ImZadeQasemzade/QDD5010-Actuator/CAD/V2/V2 arm.png

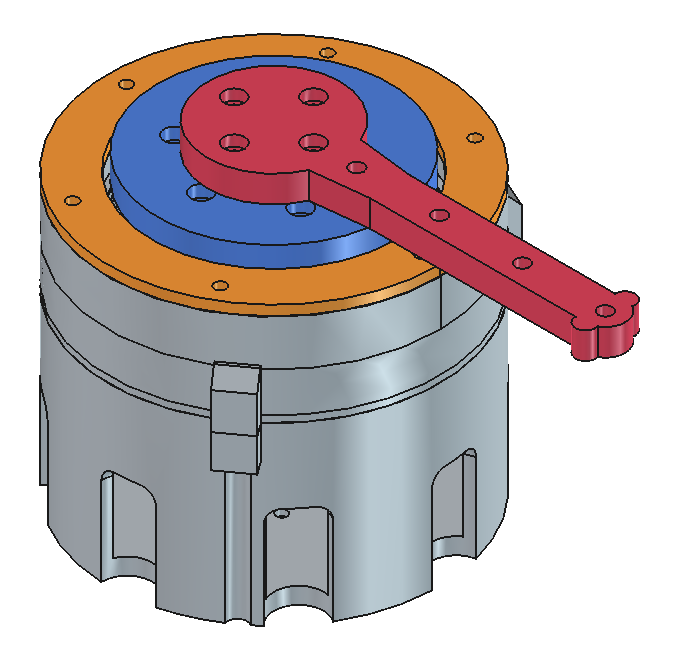
CAD/V2/V2 arm.png
