ImZadeQasemzade/QDD5010-Actuator/CAD/V2/PlanetaryGearBox 5010.FCStd

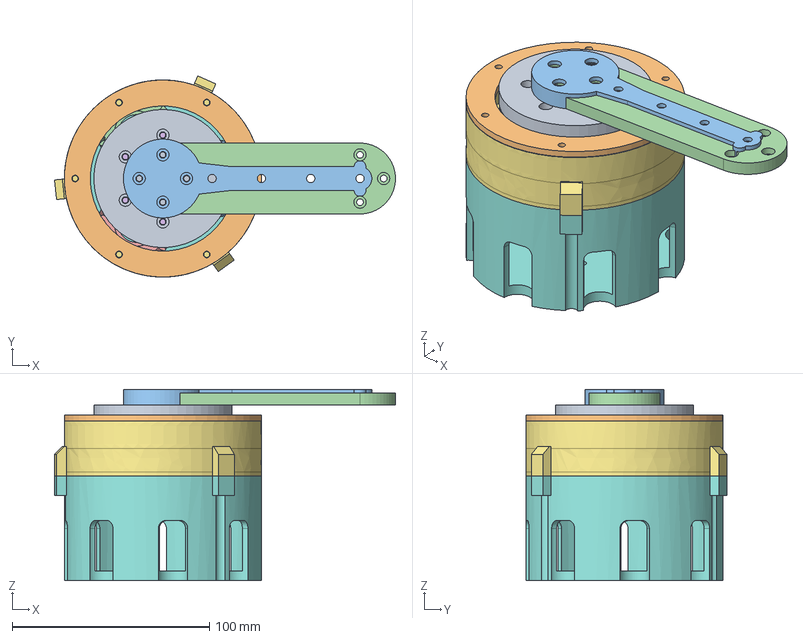
[picture p7: CAD file, 2026-11-08]
CAD/V2/PlanetaryGearBox 5010.FCStd
173.0 x 102.0 x 97.1 mm
Rotor Adapter
Sun
Planet 1
Planet 2
Planet 3
Carrier
Ring
Base
Output Flange
Bearing Retainer
Arm
Arm A1
