ImZadeQasemzade/QDD5010-Actuator/CAD/V2/PlanetaryGearBox 5010-Arm A1 Pusher.stl

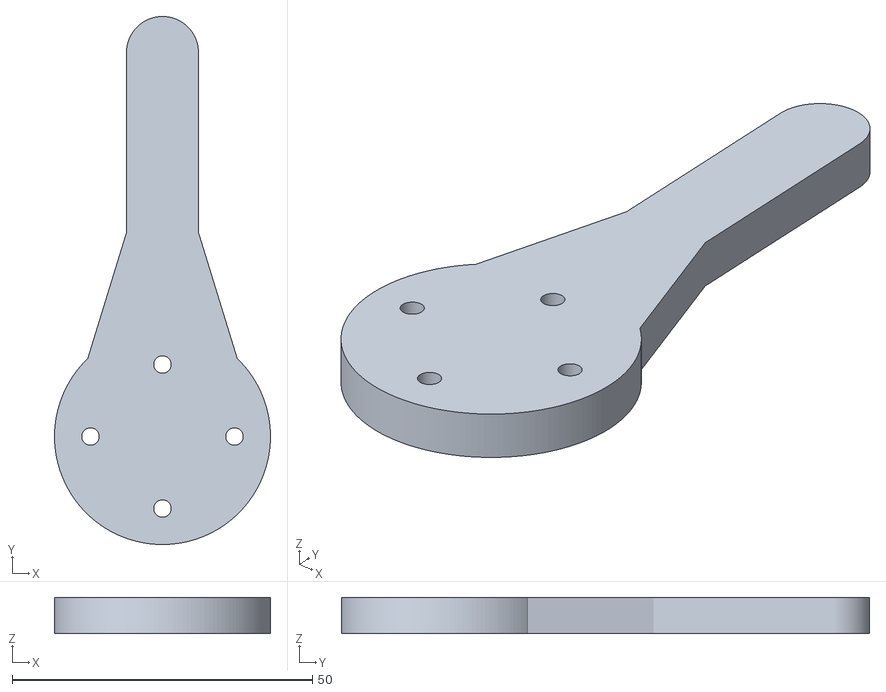
[picture p8: CAD file, 2026-11-08]
CAD/V2/PlanetaryGearBox 5010-Arm A1 Pusher.stl
36.0 x 88.0 x 6.00
