ImZadeQasemzade/QDD5010-Actuator/CAD/V2/PlanetaryGearBox 5010-Arm A1.3mf

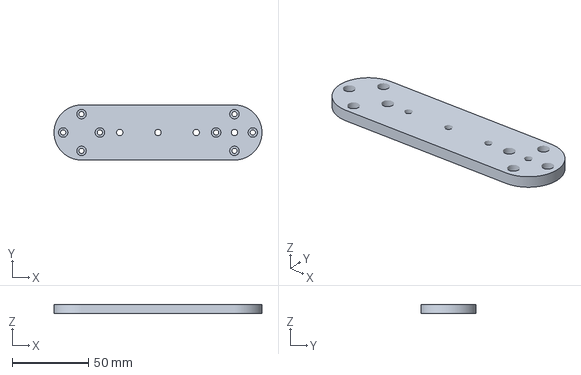
[picture p9: CAD file, 2026-11-08]
CAD/V2/PlanetaryGearBox 5010-Arm A1.3mf
136.0 x 36.0 x 6.00 mm
