ImZadeQasemzade/QDD5010-Actuator/CAD/V2/PlanetaryGearBox 5010-Sun.3mf

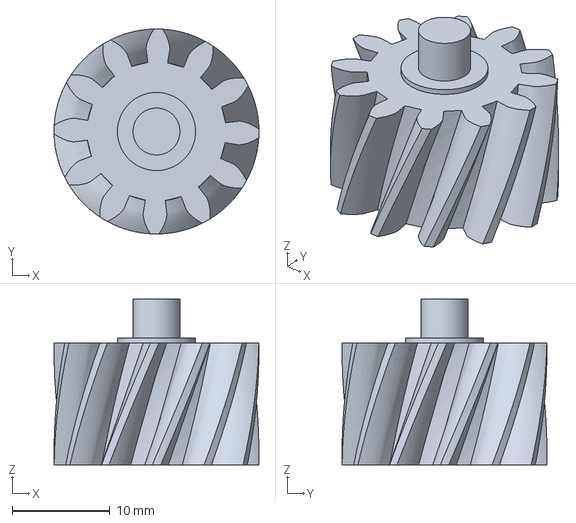
[picture p10: CAD file, 2026-11-03]
CAD/V2/PlanetaryGearBox 5010-Sun.3mf
21.0 x 21.0 x 17.0 mm
