ImZadeQasemzade/QDD5010-Actuator/CAD/V2/PlanetaryGearBox 5010-Rotor Adapter.3mf

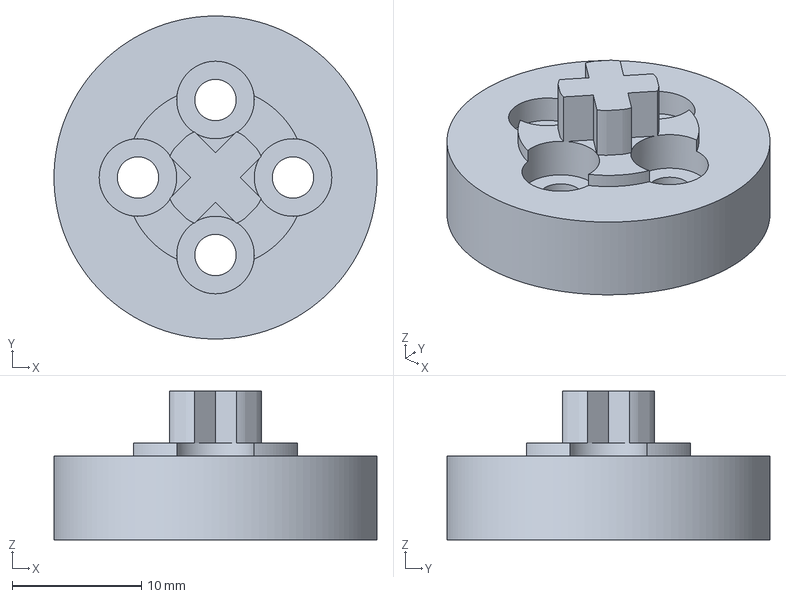
[picture p11: CAD file, 2026-11-03]
CAD/V2/PlanetaryGearBox 5010-Rotor Adapter.3mf
25.0 x 25.0 x 11.5 mm
