ImZadeQasemzade/QDD5010-Actuator/CAD/V2/PlanetaryGearBox 5010-Planet 2.3mf

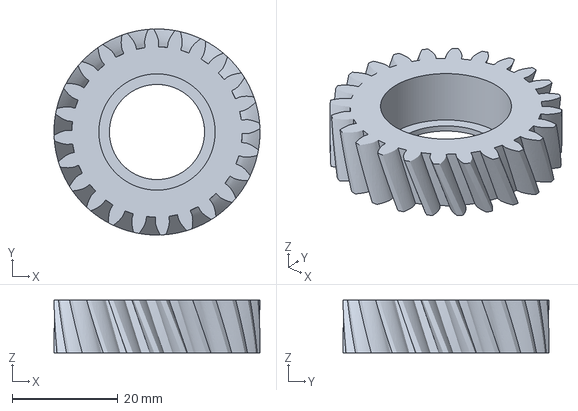
[picture p12: CAD file, 2026-11-03]
CAD/V2/PlanetaryGearBox 5010-Planet 2.3mf
39.0 x 39.0 x 10.0 mm
