ImZadeQasemzade/QDD5010-Actuator/CAD/V2/PlanetaryGearBox 5010-Carrier.3mf

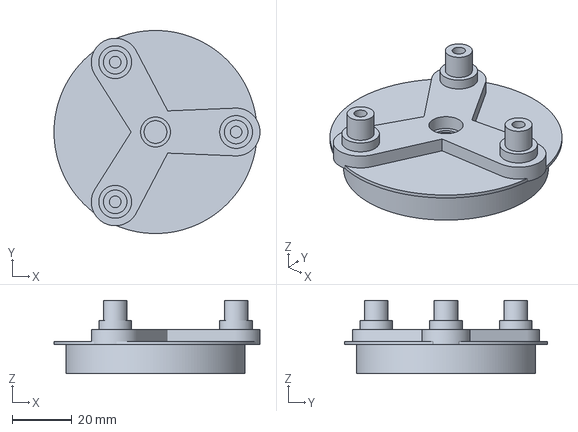
[picture p13: CAD file, 2026-11-03]
CAD/V2/PlanetaryGearBox 5010-Carrier.3mf
69.0 x 68.0 x 24.6 mm
