ImZadeQasemzade/QDD5010-Actuator/CAD/V2/PlanetaryGearBox 5010-Output Flange.3mf

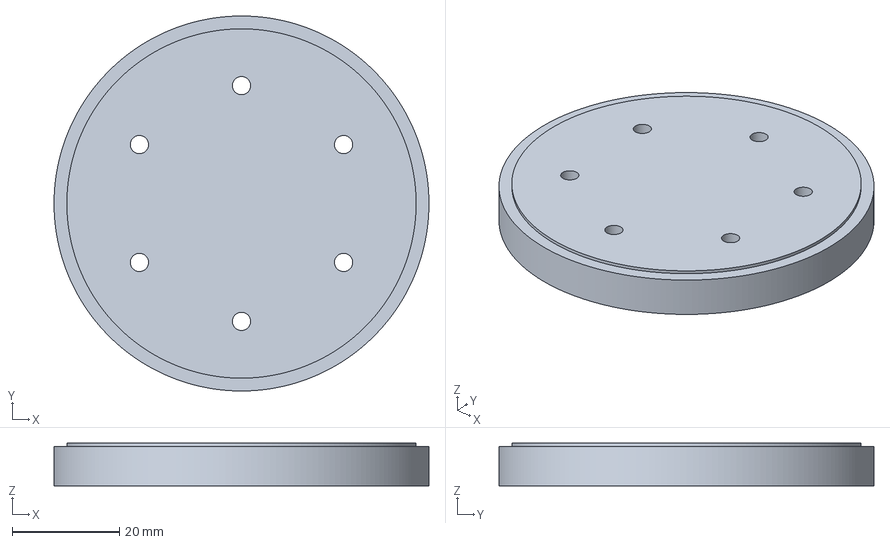
[picture p14: CAD file, 2026-11-03]
CAD/V2/PlanetaryGearBox 5010-Output Flange.3mf
70.0 x 70.0 x 8.00 mm
