ImZadeQasemzade/QDD5010-Actuator/CAD/V2/PlanetaryGearBox 5010-Base.3mf

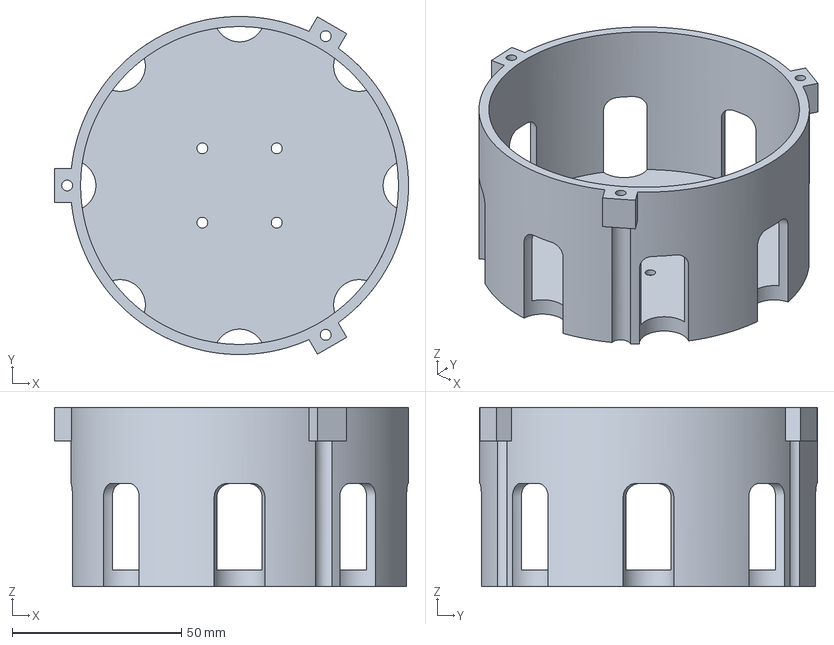
[picture p15: CAD file, 2026-11-03]
CAD/V2/PlanetaryGearBox 5010-Base.3mf
104.7 x 100.0 x 53.1 mm
