ImZadeQasemzade/QDD5010-Actuator/CAD/V2/PlanetaryGearBox 5010-Ring.3mf

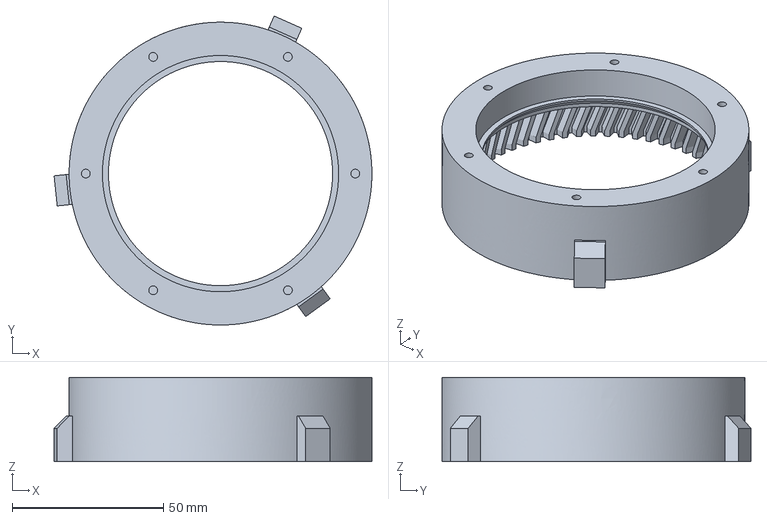
[picture p16: CAD file, 2026-11-03]
CAD/V2/PlanetaryGearBox 5010-Ring.3mf
105.0 x 102.0 x 27.8 mm
