ImZadeQasemzade/QDD5010-Actuator/CAD/V2/PlanetaryGearBox 5010-Arm.3mf

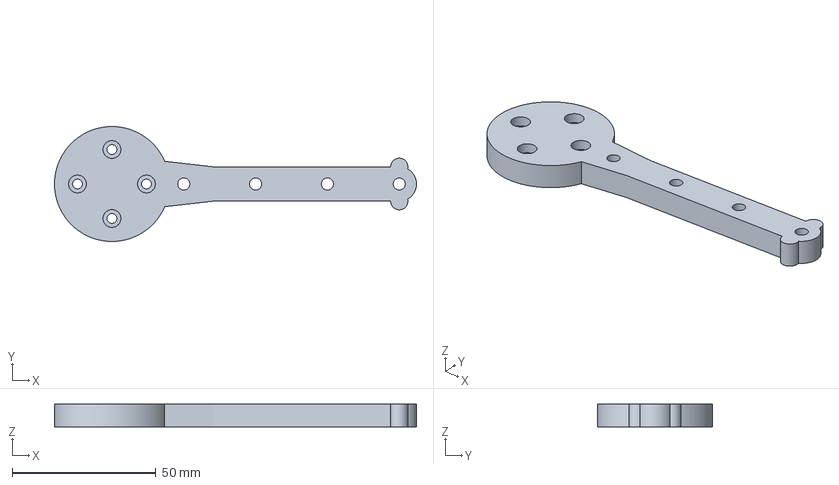
[picture p17: CAD file, 2026-11-03]
CAD/V2/PlanetaryGearBox 5010-Arm.3mf
126.0 x 40.0 x 8.00 mm
