ImZadeQasemzade/QDD5010-Actuator/CAD/V2/PlanetaryGearBox 5010-Bearing Retainer.3mf

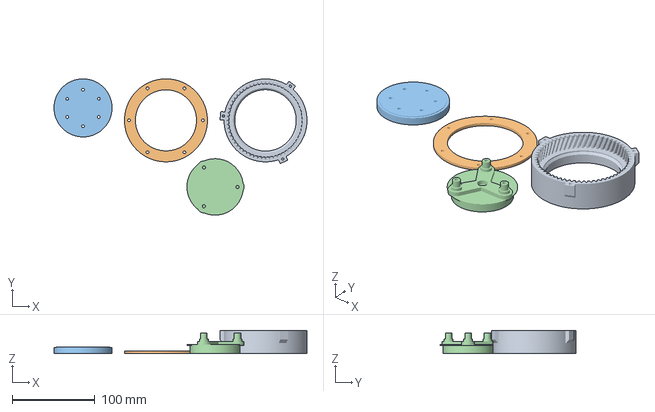
[picture p18: CAD file, 2026-11-03]
CAD/V2/PlanetaryGearBox 5010-Bearing Retainer.3mf
305.0 x 164.3 x 27.8 mm
