ImZadeQasemzade/QDD5010-Actuator/(list of files, cad)

Other CAD files:
CAD/V2/PlanetaryGearBox 5010-Planet 1.3mf
