ImZadeQasemzade/QDD5010-Actuator/(commit log)

2026-11-03 QDD5010 actuator: firmware, web console and V2 gearbox CAD
    [PlanetaryGearBox 5010-Arm.3mf, PlanetaryGearBox 5010-Base.3mf, PlanetaryGearBox 5010-Bearing Retainer.3mf, PlanetaryGearBox 5010-Carrier.3mf, PlanetaryGearBox 5010-Output Flange.3mf, PlanetaryGearBox 5010-Planet 1.3mf, PlanetaryGearBox 5010-Planet 2.3mf, PlanetaryGearBox 5010-Planet 3.3mf]
2026-11-08 Add Arm A1 and scale pusher; calibrate torque in the web console
    - CAD: Arm A1 (36 mm stadium, 6 mm, 4 x M3 at both ends, load holes at
    25/50/75/100 mm) in the FCStd and as a 3MF, plus an STL pusher that bolts
    under the arm tip and presses a wall-mounted scale at exactly 100 mm.
    - Web console: torque model from three increasing-current scale sweeps
    (2026-11-08): output torque = 0.099 x (I - 0.87) N.m when pushing on a
    load. New "Push friction" setting next to Kt, used for the external torque
    readout when the arm is held against a load and for the Torque hint.
    - Calibration card: increasing-only steps 0.5-3.5 A, prefilled with the
    measured means, fits slope and offset; rows above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
    [PlanetaryGearBox 5010-Arm A1 Pusher.stl, PlanetaryGearBox 5010-Arm A1.3mf, PlanetaryGearBox 5010.FCStd]
2026-11-08 Simpler web console, 3.5 A default limit, README pictures
    - Firmware: power-up limits raised to 3.5 A and 3.0 V (the scale
    calibration ran cleanly to 3.5-4 A; 3.0 V covers 3.5 A on a warm winding).
    - Web console: Drive card with Angle/Speed/Torque tabs (no sliders), a
    Force card, Log and Setup tabs on the right, an "i" explanation on every
    card, view and chart, two charts instead of three. The 3D model is now
    Arm A1 with the scale pusher, follows the arm turned by hand with the
    motor off, and says "No data" if telemetry stops. Calibration rows no
    longer juggle the limits; the simulator uses the new defaults.
    - README: Arm A1 and pusher, calibration results, the new console, and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
2026-11-08 Update the guide PDF: Arm A1, scale pusher, torque calibration, new console and limits
2026-11-09 Guide PDF: drop the V1-to-V2 upgrade notes for public readers
    The opening upgrade paragraph and "What to print for V2" table are gone,
    the title is now "QDD5010 Actuator: Build and Operating Guide", and the
    remaining V1/V2 labels read as the first build and the current design.
2026-11-09 Rename the guide to "QDD5010 Actuator Guide"
    The PDF is now docs/QDD5010 Actuator Guide.pdf, matching the guide's
    title; the README links follow.
